cryptovillage/badge2018/docs/led_sketch.png

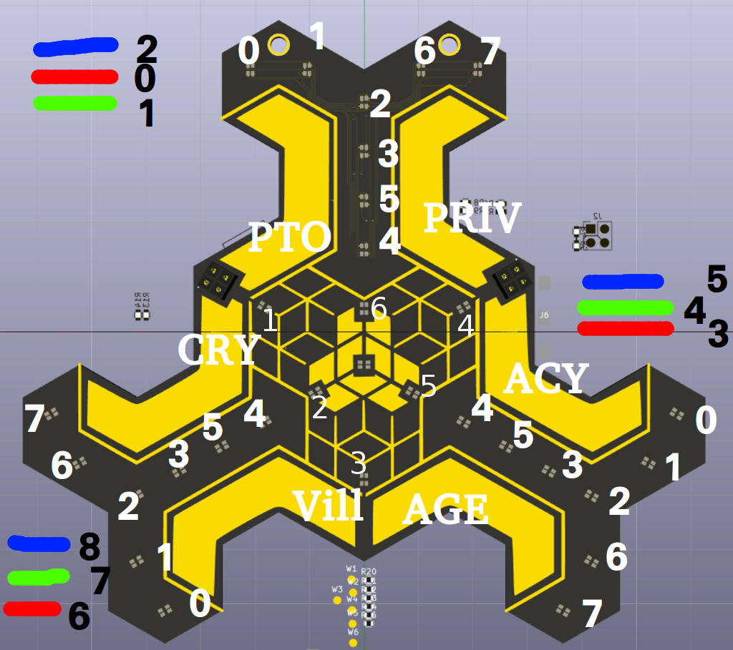
docs/led_sketch.png
