cryptovillage/badge2018/(threads)

Thread 1 (2018-08-16):

Micropython

hriday, 2018-08-16:
Hi there,

I was trying to get the dependencies and it fails on this submodule:

[submodule "firmware/esp32/components/micropython/micropython"]
        path = firmware/esp32/components/micropython/micropython
        url = git@github.com:supersat/micropython-cpv2018.git

I gather that the git repo referenced is not in GitHub?

Thanks.
