cryptovillage/badge2018/hardware/badge2018.kicad_pcb

## KiCad design hardware/badge2018.kicad_pcb (2018-08-10)

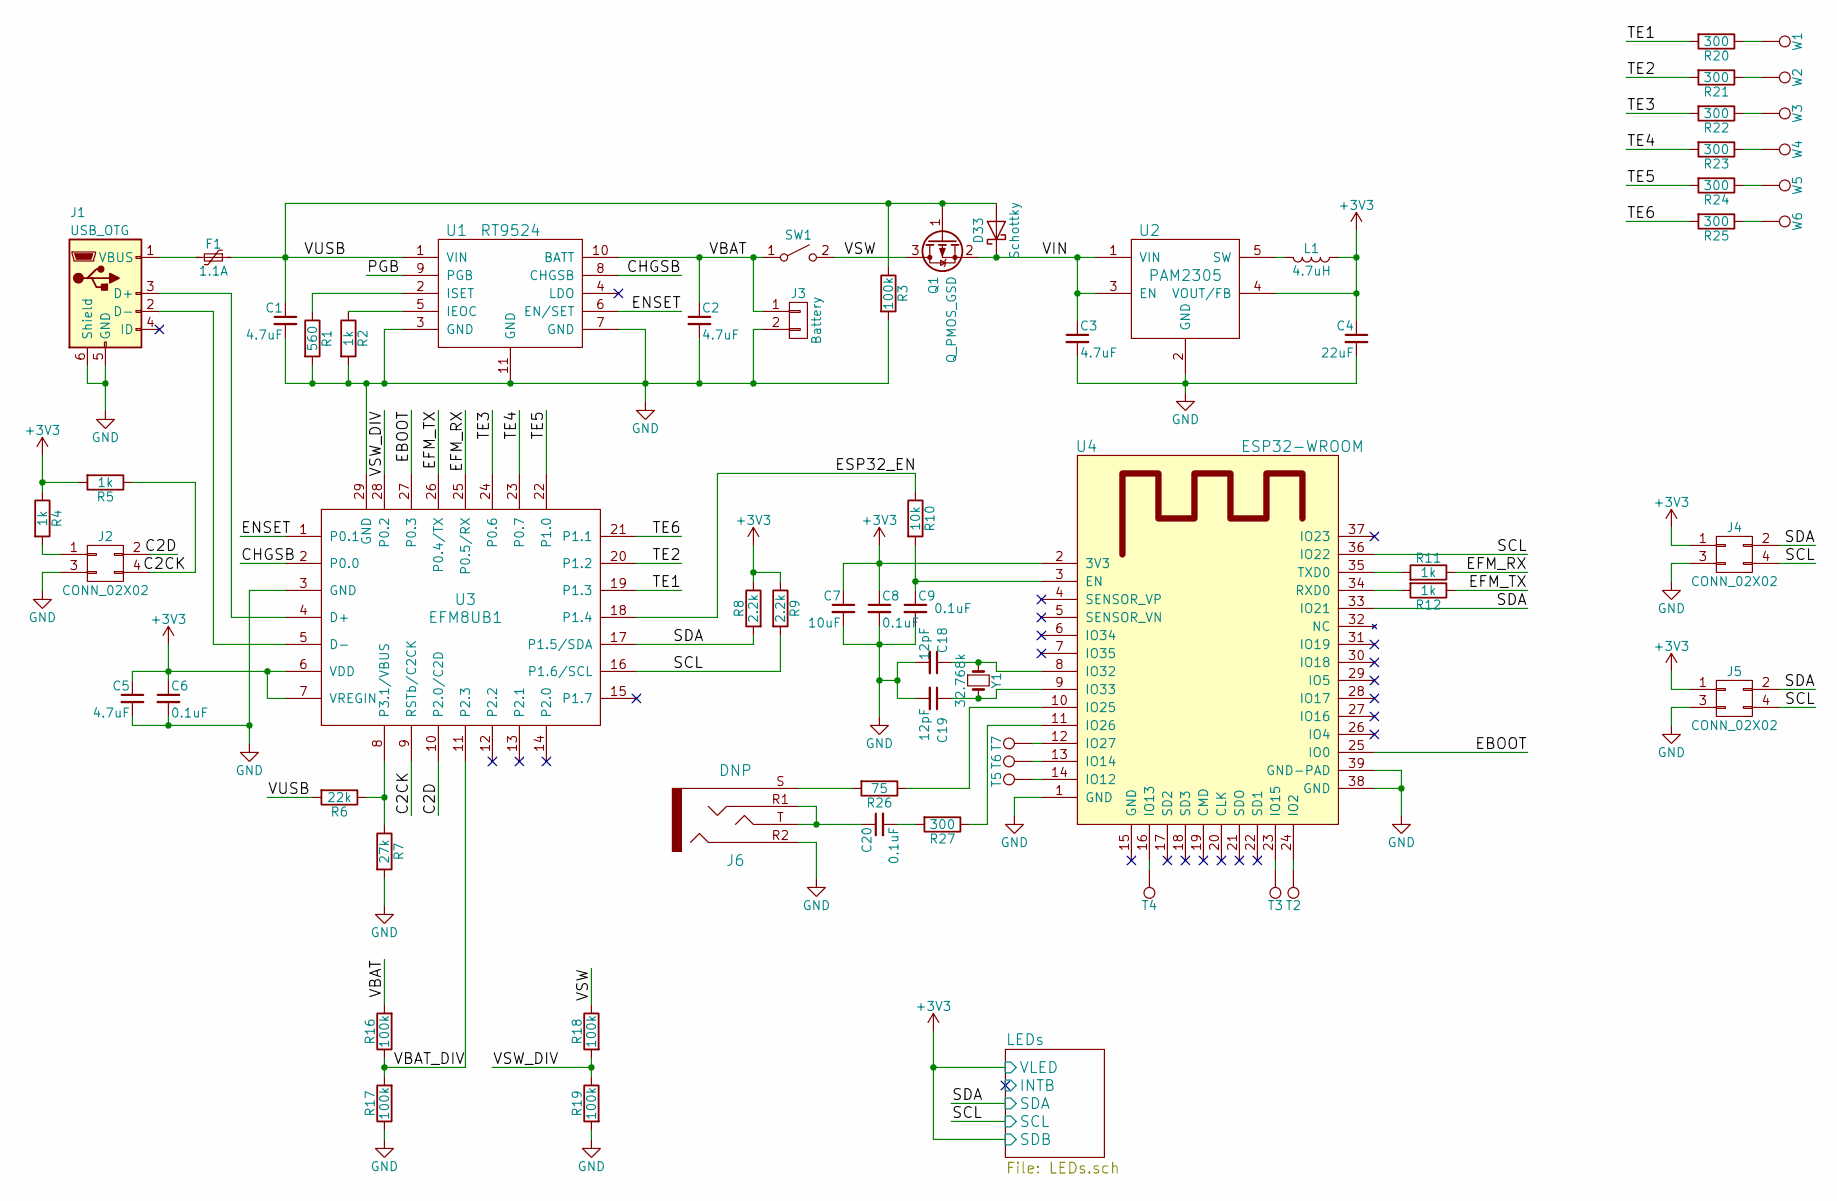
[picture p2: schematic badge2018.sch, Crypto and Privacy Village Badge 2018]

Parts:
C1, C2, C3, C5: 4.7uF; C_0603; Tolerance +/- 10%; Voltage 10V
C4: 22uF; C_0603; Tolerance +/- 10%; Voltage 10V
C6, C8, C9: 0.1uF; C_0603; Tolerance +/- 10%; Voltage 6.3V
C7: 10uF; C_0603; Tolerance +/- 10%; Voltage 10V
C18, C19: 12pF; C_0603; Tolerance +/- 10%; Voltage 6.3V
C20: 0.1uF; C_0603; Tolerance +/- 10%; Voltage 10V
D33: Schottky; D_SOD-323; MfgPartNum BAT20JFILM
F1: 1.1A; R_1210; Voltage 6V; MfgPartNum MF-USMF110-2
J1: USB_OTG; USB_Micro-B-cpv; MfgPartNum 10118192-0001LF
J2: CONN_02X02; Socket_Strip_Straight_2x02_TP
J3: Battery; JST_PH_SMD; MfgPartNum S2B-PH-SM4-TB(LF)(SN)
J4, J5: CONN_02X02; DC26_Shitty_Addon
J6: DNP; TRRS_jack; MfgPartNum SJ-43516-SMT-TR
L1: 4.7uH; R_0805
Q1: Q_PMOS_GSD; SOT-23; Voltage 30V; MfgPartNum DMG2307L-7
R1: 560; R_0603; Tolerance 1%
R2: 1k; R_0603; Tolerance 1%
R3: 100k; R_0603; Tolerance 5%
R4, R5, R11, R12: 1k; R_0603; Tolerance 5%
R6: 22k; R_0603; Tolerance 5%
R7: 27k; R_0603; Tolerance 5%
R8, R9: 2.2k; R_0603; Tolerance 5%
R10: 10k; R_0603; Tolerance 5%
R16, R17, R18, R19: 100k; R_0603; Tolerance 1%
R20, R21, R22, R23, R24: 300; R_0603; Tolerance 5%
R25, R27: 300; R_0603; Tolerance 1%
R26: 75; R_0603; Tolerance 1%
SW1: SPST; DPDT_SMD; Voltage 6V; MfgPartNum JS202011SCQN
T2, T3, T4, T5, T6, T7: TP; Measurement_Point_Round-SMD-Pad_Small
U1: RT9524; DFN-10-1EP_2x3mm_Pitch0.5mm; MfgPartNum RT9524GQW
U2: PAM2305; SOT-23-5; MfgPartNum PAM2305AAB330
U3: EFM8UB1; QFN-28-1EP_5x5mm_Pitch0.5mm; MfgPartNum EFM8UB10F16G-C-QFN28
U4: ESP32-WROOM; MfgPartNum ESP-WROOM-32
W1, W2, W3, W4, W5, W6: TP; Measurement_Point_Round-SMD-Pad_Small
Y1: 32.768k; abs25_crystal; MfgPartNum ABS25-32.768KHZ-T

Connections:
+3V3: C4.1, C5.1, C6.1, C7.1, C8.1, J4.1, J5.1, L1.1, R4.1, R5.2, R8.1, R9.1, U2.4 (VOUT/FB), U3.6 (VDD), U3.7 (VREGIN), U4.2 (3V3); also elsewhere on the board
/C2CK: J2.4, R5.1, U3.9 (RSTb/C2CK)
/C2D: J2.2, U3.10 (P2.0/C2D)
/CHGSB: U1.8 (CHGSB), U3.2 (P0.0)
/EBOOT: U3.27 (P0.3), U4.25 (IO0)
/EFM_RX: R11.1, U3.25 (P0.5/RX)
/EFM_TX: R12.1, U3.26 (P0.4/TX)
/ENSET: U1.6 (EN/SET), U3.1 (P0.1)
/ESP32_EN: R10.1, U3.18 (P1.4)
/PGB: U1.9 (PGB)
/SCL: J4.4, J5.4, R9.2, U3.16 (P1.6/SCL), U4.36 (IO22); also elsewhere on the board
/SDA: J4.2, J5.2, R8.2, U3.17 (P1.5/SDA), U4.33 (IO21); also elsewhere on the board
/TE1: R20.2, U3.19 (P1.3)
/TE2: R21.2, U3.20 (P1.2)
/TE3: R22.2, U3.24 (P0.6)
/TE4: R23.2, U3.23 (P0.7)
/TE5: R24.2, U3.22 (P1.0)
/TE6: R25.2, U3.21 (P1.1)
/VBAT: C2.1, J3.1, R16.2, SW1.1 (A), U1.10 (BATT)
/VBAT_DIV: R16.1, R17.2, U3.11 (P2.3)
/VIN: C3.1, D33.1 (K), Q1.2 (S), U2.1 (VIN), U2.3 (EN)
/VSW: Q1.3 (D), R18.1, SW1.2 (B)
/VSW_DIV: R18.2, R19.1, U3.28 (P0.2)
/VUSB: C1.1, D33.2 (A), F1.1, Q1.1 (G), R3.1, R6.2, U1.1 (VIN)
GND: C1.2, C2.2, C3.2, C4.2, C5.2, C6.2, C7.2, C8.2, C9.2, C18.2, C19.2, J1.5 (GND), J1.6 (Shield), J2.3, J3.2, J4.3, J5.3, J6.R2, R1.2, R2.2, R3.2, R7.2, R17.1, R19.2, U1.3 (GND), U1.7 (GND), U1.11 (GND), U2.2 (GND), U3.3 (GND), U3.29 (GND), U4.1 (GND), U4.38 (GND), U4.39 (GND-PAD); also elsewhere on the board
unnamed: C9.1, R10.2, U4.3 (EN)
unnamed: C18.1, U4.8 (IO32), Y1.1
unnamed: C19.1, U4.9 (IO33), Y1.2
unnamed: C20.1, J6.R1, J6.T
unnamed: C20.2, R27.2
unnamed: F1.2, J1.1 (VBUS)
unnamed: J1.2 (D-), U3.5 (D-)
unnamed: J1.3 (D+), U3.4 (D+)
unnamed: J2.1, R4.2
unnamed: J6.S, R26.2
unnamed: L1.2, U2.5 (SW)
unnamed: R1.1, U1.2 (ISET)
unnamed: R2.1, U1.5 (IEOC)
unnamed: R6.1, R7.1, U3.8 (P3.1/VBUS)
unnamed: R11.2, U4.35 (TXD0)
unnamed: R12.2, U4.34 (RXD0)
unnamed: R20.1, W1.1
unnamed: R21.1, W2.1
unnamed: R22.1, W3.1
unnamed: R23.1, W4.1
unnamed: R24.1, W5.1
unnamed: R25.1, W6.1
unnamed: R26.1, U4.10 (IO25)
unnamed: R27.1, U4.11 (IO26)
unnamed: T2.1, U4.24 (IO2)
unnamed: T3.1, U4.23 (IO15)
unnamed: T4.1, U4.16 (IO13)
unnamed: T5.1, U4.14 (IO12)
unnamed: T6.1, U4.13 (IO14)
unnamed: T7.1, U4.12 (IO27)

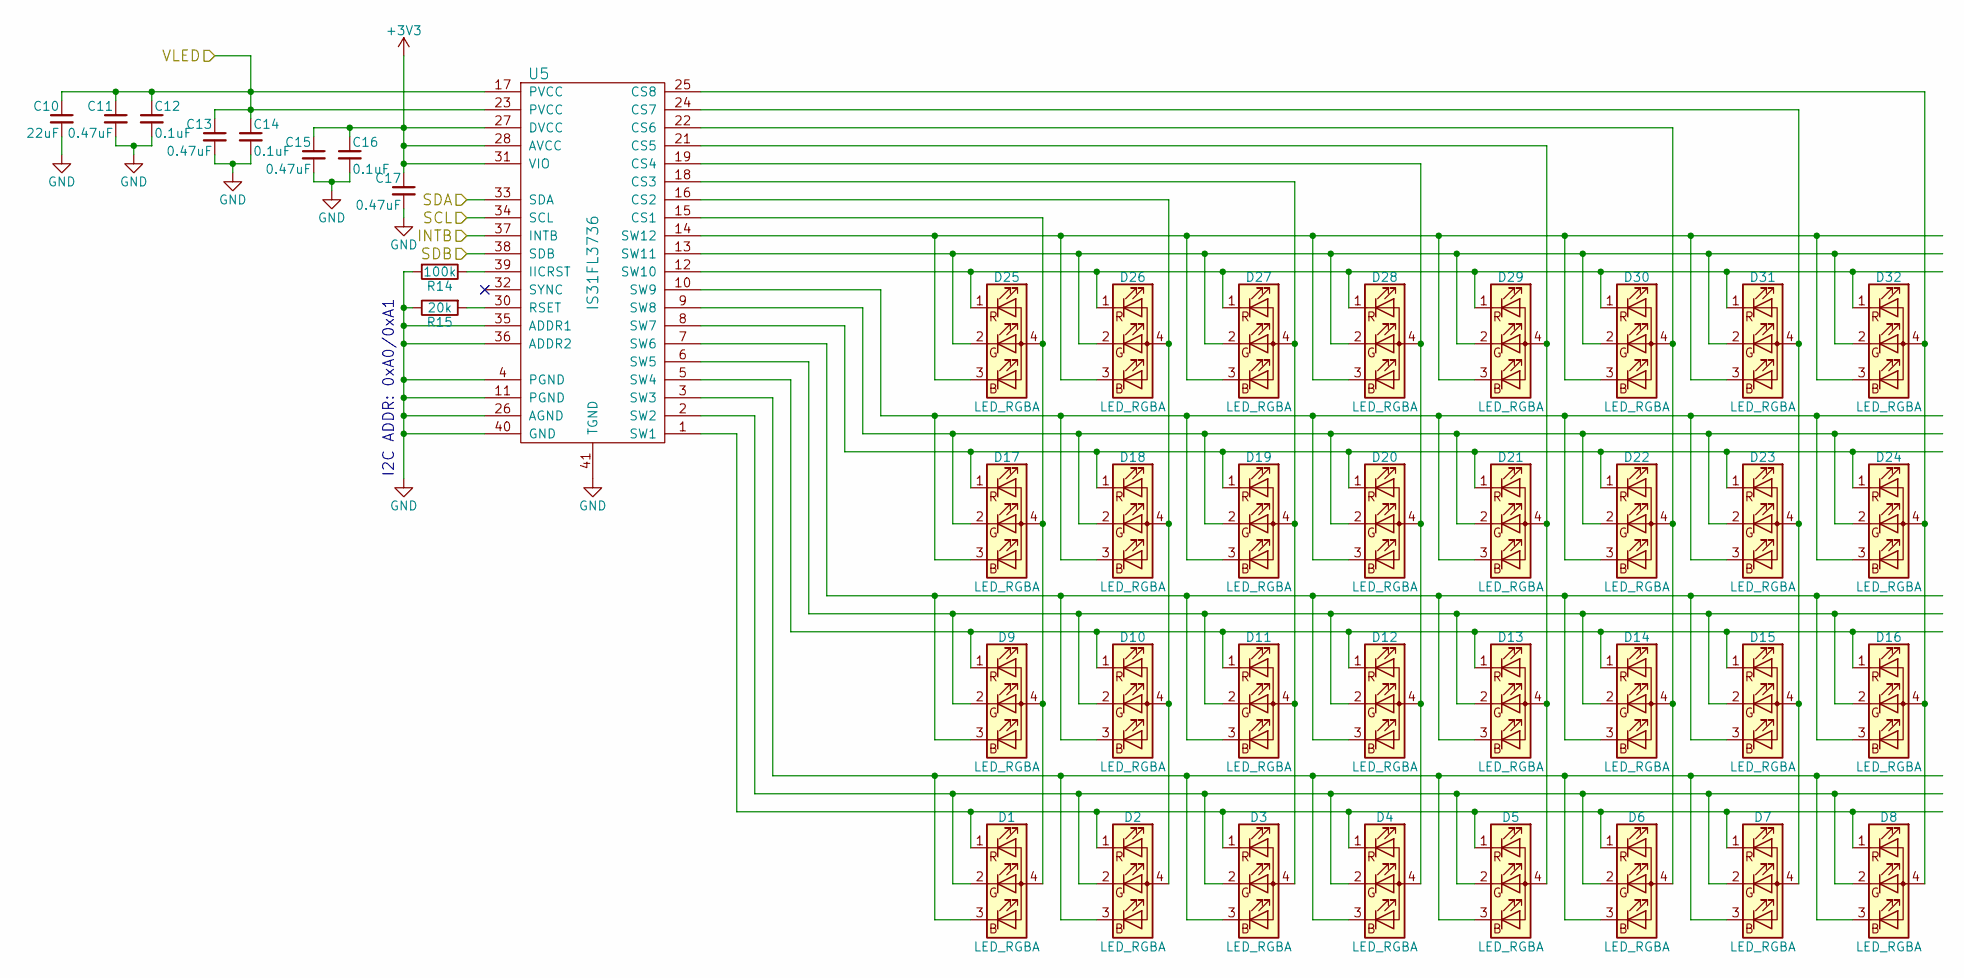
[picture p3: schematic LEDs.sch]

Parts:
C10: 22uF; C_0603; Tolerance +/- 10%; Voltage 10V
C11, C13, C15, C17: 0.47uF; C_0603; Tolerance +/- 10%; Voltage 6.3V
C12, C14, C16: 0.1uF; C_0603; Tolerance +/- 10%; Voltage 6.3V
D1, D2, D3, D4, D5, D6, D7, D8, D9, D10, D11, D12, D13, D14, D15, D16, D17, D18, D19, D20, D21, D22, D23, D24, D25, D26, D27, D28, D29, D30, D31, D32: LED_RGBA; RGBC_LED
R14: 100k; R_0603; Tolerance 0.05
R15: 20k; R_0603; Tolerance 0.01
U5: IS31FL3736; QFN-40-1EP_5x5mm_Pitch0.4mm

Connections:
+3V3: C10.1, C11.1, C12.1, C13.1, C14.1, C15.1, C16.1, C17.1, U5.17 (PVCC), U5.23 (PVCC), U5.27 (DVCC), U5.28 (AVCC), U5.31 (VIO), U5.38 (SDB); also elsewhere on the board
/LEDs/INTB: U5.37 (INTB)
/SCL: U5.34 (SCL); also elsewhere on the board
/SDA: U5.33 (SDA); also elsewhere on the board
GND: C10.2, C11.2, C12.2, C13.2, C14.2, C15.2, C16.2, C17.2, R14.2, R15.1, U5.4 (PGND), U5.11 (PGND), U5.26 (AGND), U5.35 (ADDR1), U5.36 (ADDR2), U5.40 (GND), U5.41 (TGND); also elsewhere on the board
unnamed: D1.1 (RK), D2.1 (RK), D3.1 (RK), D4.1 (RK), D5.1 (RK), D6.1 (RK), D7.1 (RK), D8.1 (RK), U5.1 (SW1)
unnamed: D1.2 (GK), D2.2 (GK), D3.2 (GK), D4.2 (GK), D5.2 (GK), D6.2 (GK), D7.2 (GK), D8.2 (GK), U5.2 (SW2)
unnamed: D1.3 (BK), D2.3 (BK), D3.3 (BK), D4.3 (BK), D5.3 (BK), D6.3 (BK), D7.3 (BK), D8.3 (BK), U5.3 (SW3)
unnamed: D1.4 (A), D9.4 (A), D17.4 (A), D25.4 (A), U5.15 (CS1)
unnamed: D9.1 (RK), D10.1 (RK), D11.1 (RK), D12.1 (RK), D13.1 (RK), D14.1 (RK), D15.1 (RK), D16.1 (RK), U5.5 (SW4)
unnamed: D9.2 (GK), D10.2 (GK), D11.2 (GK), D12.2 (GK), D13.2 (GK), D14.2 (GK), D15.2 (GK), D16.2 (GK), U5.6 (SW5)
unnamed: D9.3 (BK), D10.3 (BK), D11.3 (BK), D12.3 (BK), D13.3 (BK), D14.3 (BK), D15.3 (BK), D16.3 (BK), U5.7 (SW6)
unnamed: D2.4 (A), D10.4 (A), D18.4 (A), D26.4 (A), U5.16 (CS2)
unnamed: D3.4 (A), D11.4 (A), D19.4 (A), D27.4 (A), U5.18 (CS3)
unnamed: D4.4 (A), D12.4 (A), D20.4 (A), D28.4 (A), U5.19 (CS4)
unnamed: D5.4 (A), D13.4 (A), D21.4 (A), D29.4 (A), U5.21 (CS5)
unnamed: D6.4 (A), D14.4 (A), D22.4 (A), D30.4 (A), U5.22 (CS6)
unnamed: D7.4 (A), D15.4 (A), D23.4 (A), D31.4 (A), U5.24 (CS7)
unnamed: D8.4 (A), D16.4 (A), D24.4 (A), D32.4 (A), U5.25 (CS8)
unnamed: D17.1 (RK), D18.1 (RK), D19.1 (RK), D20.1 (RK), D21.1 (RK), D22.1 (RK), D23.1 (RK), D24.1 (RK), U5.8 (SW7)
unnamed: D17.2 (GK), D18.2 (GK), D19.2 (GK), D20.2 (GK), D21.2 (GK), D22.2 (GK), D23.2 (GK), D24.2 (GK), U5.9 (SW8)
unnamed: D17.3 (BK), D18.3 (BK), D19.3 (BK), D20.3 (BK), D21.3 (BK), D22.3 (BK), D23.3 (BK), D24.3 (BK), U5.10 (SW9)
unnamed: D25.1 (RK), D26.1 (RK), D27.1 (RK), D28.1 (RK), D29.1 (RK), D30.1 (RK), D31.1 (RK), D32.1 (RK), U5.12 (SW10)
unnamed: D25.2 (GK), D26.2 (GK), D27.2 (GK), D28.2 (GK), D29.2 (GK), D30.2 (GK), D31.2 (GK), D32.2 (GK), U5.13 (SW11)
unnamed: D25.3 (BK), D26.3 (BK), D27.3 (BK), D28.3 (BK), D29.3 (BK), D30.3 (BK), D31.3 (BK), D32.3 (BK), U5.14 (SW12)
unnamed: R14.1, U5.39 (IICRST)
unnamed: R15.2, U5.30 (RSET)

Notes on the sheet:
I2C ADDR: 0xA0/0xA1

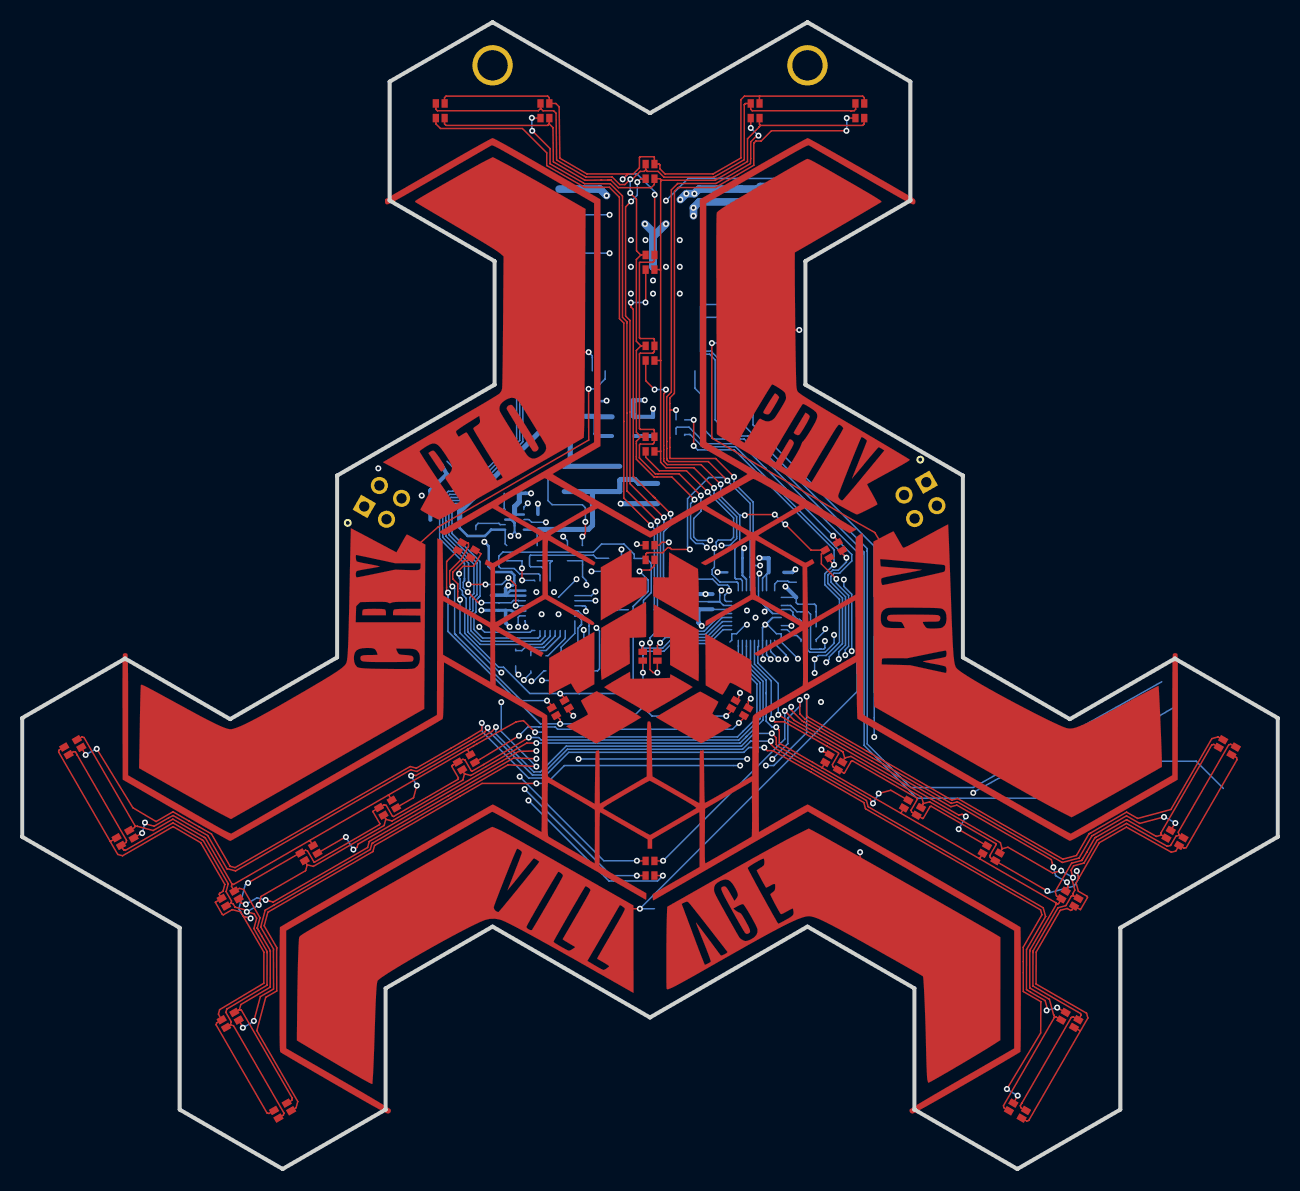
[picture p4: board badge2018.kicad_pcb from above]

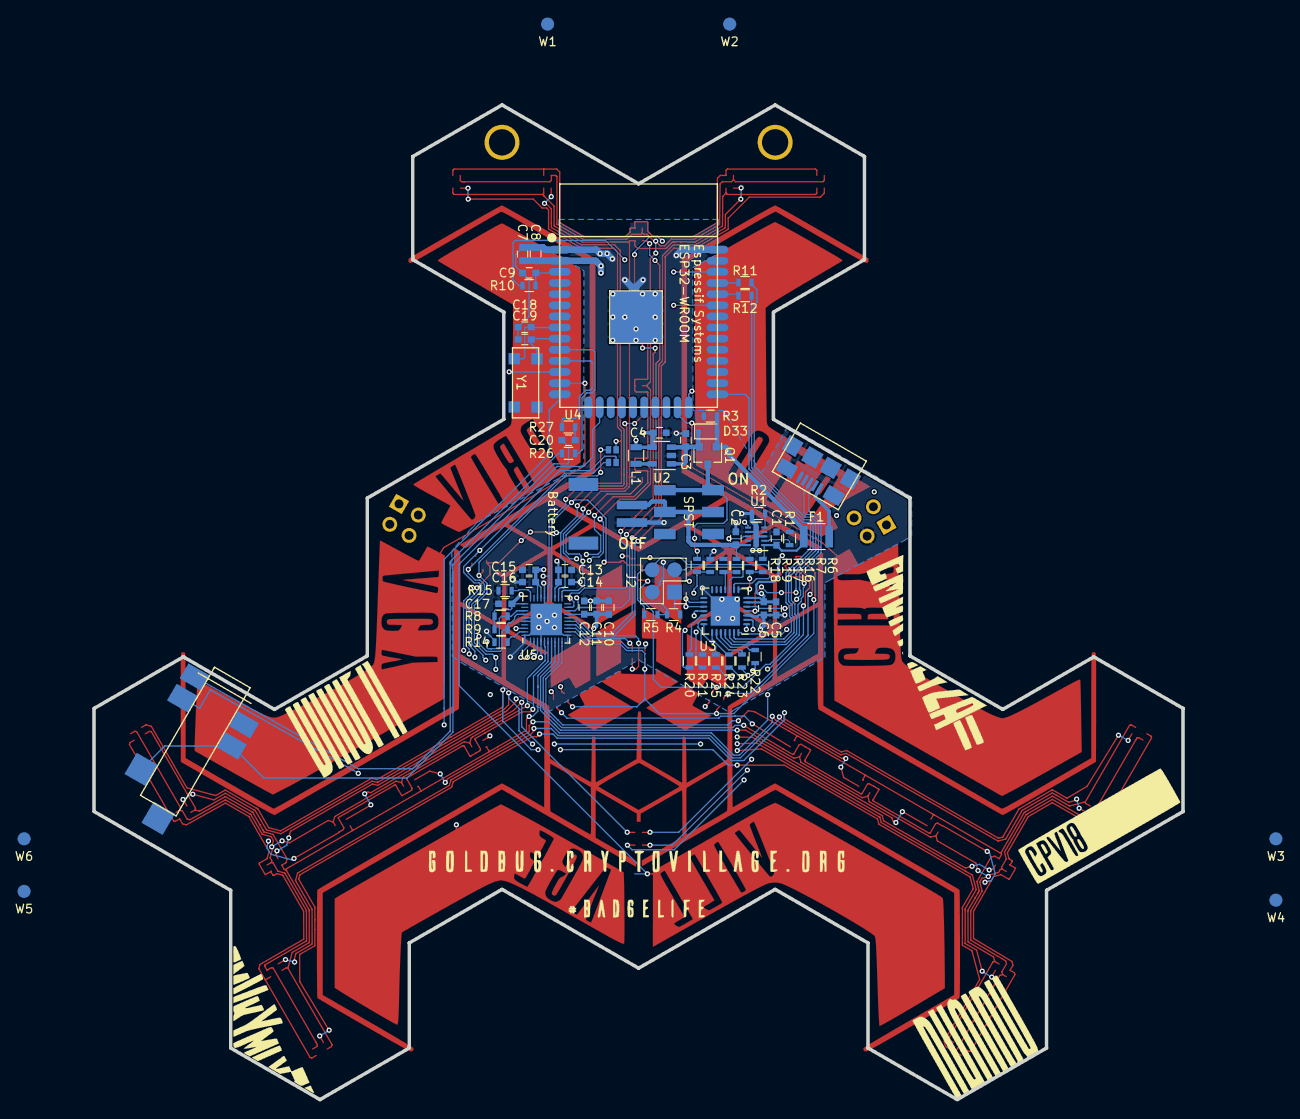
[picture p5: board badge2018.kicad_pcb from below]

Board: 4 copper layers, 124.3 x 113.5 mm, 112 parts (68 on the bottom side), 76 nets.

Other parts of the board:
ART1: COPPER; copperfrontfixedFCu
ART2: MASK; copperfrontfixedFMask
Battery: LP803860
hole_l: hole
hole_l#2: hole
