cryptovillage/badge2018/firmware/efm8ub1/factory/inc/config/efm8_config.h

/******************************************************************************
 * Copyright (c) 2014 by Silicon Laboratories Inc. All rights reserved.
 *
 * http://developer.silabs.com/legal/version/v11/Silicon_Labs_Software_License_Agreement.txt
 *****************************************************************************/
 
#ifndef __EFM8_CONFIG_H__
#define __EFM8_CONFIG_H__

#define EFM8PDL_SPI0_USE                  1
#define EFM8PDL_SPI0_USE_BUFFER           1
#define EFM8PDL_SPI0_USE_FIFO             0
#define EFM8PDL_SPI0_TX_SEGTYPE           SI_SEG_PDATA

//Select UART driver options
#define EFM8PDL_UART0_USE 1
#define EFM8PDL_UART0_USE_BUFFER 1

#endif // __EFM8_CONFIG_H__
