cryptovillage/badge2018/firmware/efm8ub1/factory/src/descriptor.c

/**************************************************************************//**
 * @file
 * @brief   Hardware initialization functions.
 * @author  Silicon Laboratories
 * @version 1.0.0 (DM: July 14, 2014)
 *
 *******************************************************************************
 * @section License
 * (C) Copyright 2014 Silicon Labs Inc,
 * http://developer.silabs.com/legal/version/v11/Silicon_Labs_Software_License_Agreement.txt
 *******************************************************************************
 *
 * Descriptor information to pass to USB_Init()
 * 
 *****************************************************************************/

#include "descriptor.h"

/*** [BEGIN] USB Descriptor Information [BEGIN] ***/

#define STRING1_LEN sizeof ("Silicon Labs") * 2
const uint8_t code USB_MfrStr[] = // Manufacturer String
{
   STRING1_LEN, 0x03,
   'S', 0,
   'i', 0,
   'l', 0,
   'i', 0,
   'c', 0,
   'o', 0,
   'n', 0,
   ' ', 0,
   'L', 0,
   'a', 0,
   'b', 0,
   's', 0,
};

#define STRING2_LEN sizeof("CP2103 USB to UART Bridge Controller") * 2
const uint8_t code USB_ProductStr[] = // Product Desc. String
{
   STRING2_LEN, 0x03,
   'C', 0,
   'P', 0,
   '2', 0,
   '1', 0,
   '0', 0,
   '3', 0,
   ' ', 0,
   'U', 0,
   'S', 0,
   'B', 0,
   ' ', 0,
   't', 0,
   'o', 0,
   ' ', 0,
   'U', 0,
   'A', 0,
   'R', 0,
   'T', 0,
   ' ', 0,
   'B', 0,
   'r', 0,
   'i', 0,
   'd', 0,
   'g', 0,
   'e', 0,
   ' ', 0,
   'C', 0,
   'o', 0,
   'n', 0,
   't', 0,
   'r', 0,
   'o', 0,
   'l', 0,
   'l', 0,
   'e', 0,
   'r', 0
};

#define STRING3_LEN sizeof("0000") * 2
const uint8_t code USB_SerialStr[] = // Serial Number String
{
   STRING3_LEN, 0x03,
   '0', 0,
   '0', 0,
   '0', 0,
   '5', 0
};


const VCPXpress_Init_TypeDef InitStruct =
{
   0x10C4,                 // Vendor ID
   0xEA60,                 // Product ID
   USB_MfrStr,             // Pointer to Manufacturer String
   USB_ProductStr,         // Pointer to Product String
   USB_SerialStr,          // Pointer to Serial String
   250,                    // Max Power / 2
   0x80,                   // Power Attribute
   0x0100,                 // Device Release # (BCD format)
   false                   // Use USB FIFO space true
};
