cryptovillage/badge2018/firmware/efm8ub1/bootloader/inc/boot.h

/******************************************************************************
 * Copyright (c) 2015 by Silicon Laboratories Inc. All rights reserved.
 *
 * http://developer.silabs.com/legal/version/v11/Silicon_Labs_Software_License_Agreement.txt
 *****************************************************************************/

#ifndef __BOOT_H__
#define __BOOT_H__

/// Defines the boot frame start byte
#define BOOT_FRAME_START  '$'

/// Bootloader command byte definitions
#define BOOT_CMD_IDENT    '0'
#define BOOT_CMD_SETUP    '1'
#define BOOT_CMD_ERASE    '2'
#define BOOT_CMD_WRITE    '3'
#define BOOT_CMD_VERIFY   '4'
#define BOOT_CMD_LOCK     '5'
#define BOOT_CMD_RUNAPP   '6'

/// Bootloader response byte definitions
#define BOOT_ACK_REPLY    '@'
#define BOOT_ERR_RANGE    'A'
#define BOOT_ERR_BADID    'B'
#define BOOT_ERR_CRC      'C'

/// This array provides access to the bootloader signature and lock byte.
///   boot_otp[0] = bootloader signature byte
///   boot_otp[1] = flash lock byte
extern uint8_t SI_SEG_CODE boot_otp[];

// Used to implement boot_hasRemaining() macro below
extern uint8_t boot_rxSize;

/**************************************************************************//**
 * Initialize device hardware and start the communication channel.
 *****************************************************************************/
extern void boot_initDevice(void);

/**************************************************************************//**
 * Wait for the next boot record to arrive.
 *****************************************************************************/
extern void boot_nextRecord(void);

/**************************************************************************//**
 * Get the next byte in the boot record.
 *
 * @return The next byte from the boot record
 *****************************************************************************/
extern uint8_t boot_getByte(void);

/**************************************************************************//**
 * Get the next word in the boot record.
 *
 * @return The next 16-bit word from the boot record
 *****************************************************************************/
extern uint16_t boot_getWord(void);

/**************************************************************************//**
 * Returns the number of bytes remaining in the boot record.
 *
 * @return The number of bytes remaining in the current boot record
 *****************************************************************************/
#if defined(IS_DOXYGEN)
extern uint8_t boot_hasRemaining(void);
#else
#define boot_hasRemaining(i) (boot_rxSize)
#endif

/**************************************************************************//**
 * Send a one byte reply to the host.
 *
 * @param reply The byte to send.
 *****************************************************************************/
extern void boot_sendReply(uint8_t reply);

/**************************************************************************//**
 * Exit bootloader and start the user application.
 *****************************************************************************/
extern void boot_runApp(void);

#endif // __BOOT_H__
