cryptovillage/badge2018/firmware/efm8ub1/bootloader/src/boot_init.c

/******************************************************************************
 * Copyright (c) 2015 by Silicon Laboratories Inc. All rights reserved.
 *
 * http://developer.silabs.com/legal/version/v11/Silicon_Labs_Software_License_Agreement.txt
 *****************************************************************************/

#include "efm8_device.h"
#include "boot.h"
#include "USB_main.h"

// ----------------------------------------------------------------------------
// Initialize all hardware resources needed by the bootloader.
// ----------------------------------------------------------------------------
void boot_initDevice(void) 
{
  //Disable Watchdog with key sequence
  WDTCN = 0xDE;
  WDTCN = 0xAD;

  // Enable VDD monitor and set it as a reset source
  VDM0CN |= VDM0CN_VDMEN__ENABLED;
  RSTSRC = RSTSRC_PORSF__SET;

  // PFE0CN - Prefetch Engine Control
  // PFEN (Prefetch Enable) = ENABLED (Enable the prefetch engine (SYSCLK > 25 MHz).)
  // FLRT (Flash Read Timing) = SYSCLK_BELOW_50_MHZ (SYSCLK < 50 MHz.)
  SET_SFRPAGE(PG2_PAGE);
  PFE0CN = PFE0CN_PFEN__ENABLED | PFE0CN_FLRT__SYSCLK_BELOW_50_MHZ;

  // CLKSEL - Clock Select
  // CLKSL (Clock Source Select) = HFOSC1 (Clock derived from the Internal
  //     High Frequency Oscillator 1.)
  // CLKDIV (Clock Source Divider) = SYSCLK_DIV_1 (SYSCLK is equal to
  //     selected clock source divided by 1.)
  CLKSEL = CLKSEL_CLKSL__HFOSC0 | CLKSEL_CLKDIV__SYSCLK_DIV_1;
  while(CLKSEL & CLKSEL_DIVRDY__BMASK == CLKSEL_DIVRDY__NOT_READY);
  CLKSEL = CLKSEL_CLKSL__HFOSC1 | CLKSEL_CLKDIV__SYSCLK_DIV_1;

  SET_SFRPAGE(LEGACY_PAGE);
  // P0MDOUT - Port 0 Output Mode
  // P0.4 (UART0.TX) = PUSH_PULL
  P0MDOUT = P0MDOUT_B4__PUSH_PULL;

  // XBR0 - Port I/O Crossbar 0
  // URT0E (UART0 I/O Enable) = ENABLED (UART0 TX0, RX0 routed to Port pins P0.4 and P0.5.)
  XBR0 = XBR0_URT0E__ENABLED;

  // XBR2 - Port I/O Crossbar 2
  // WEAKPUD (Port I/O Weak Pullup Disable) = PULL_UPS_ENABLED (Weak Pullups enabled.)
  // XBARE (Crossbar Enable) = ENABLED (Crossbar enabled.)
  XBR2 = XBR2_WEAKPUD__PULL_UPS_ENABLED | XBR2_XBARE__ENABLED;

  // Configure Timer 1 for baud-rate generation
  CKCON0 = (1 << 3); // Timer 1 uses SYSCLK
  TH1 = (0x30 << TH1_TH1__SHIFT); // 115200
  TMOD = TMOD_T1M__MODE2;       // 8-bit timer with auto-reload
  TCON = 0;
  TCON_TR1 = 1;

  // Enable UART0 receiver
  SCON0 = 0;
  SCON0_REN = 1;

  // Source the USB clock from HFOSC1 (48 MHz)
  SET_SFRPAGE(USB0_PAGE);
  USB0CF = USB0CF_USBCLK__HFOSC1;

  // Initialize the USB driver
  USB_initModule();
}
